retrobuiltRyan/CoinPusher/Coin Pusher v2_Elect Diagram.png

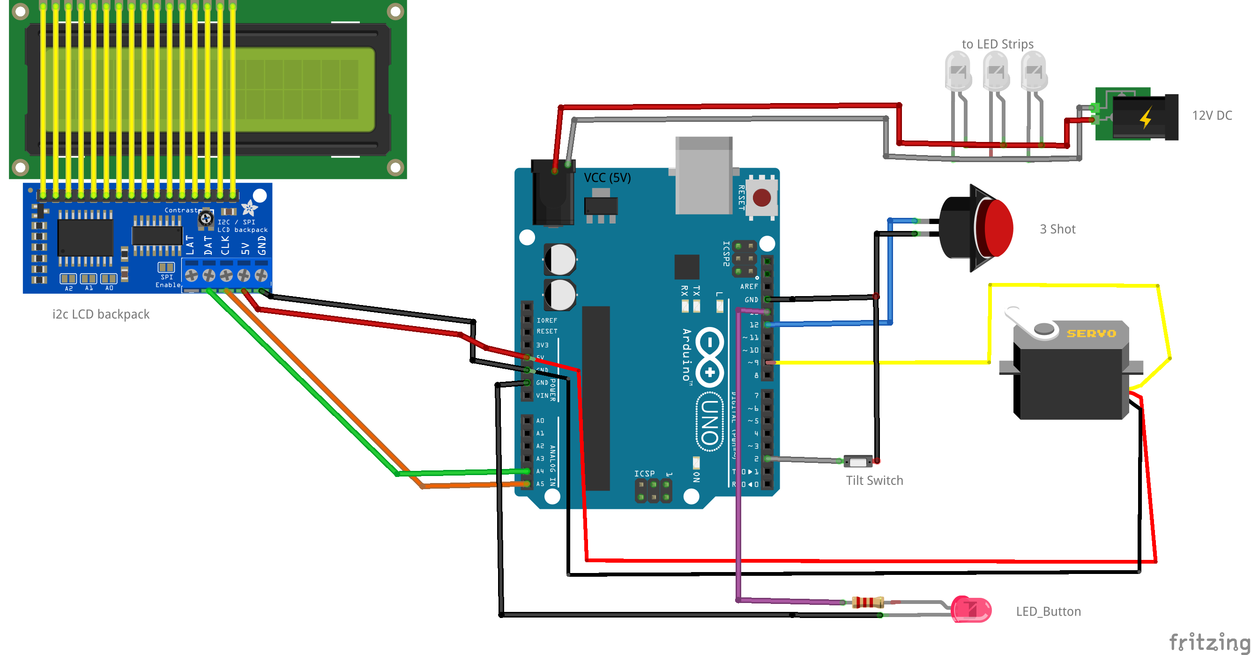
Coin Pusher v2_Elect Diagram.png
